bruestel/labelbee/case/lid-face.png

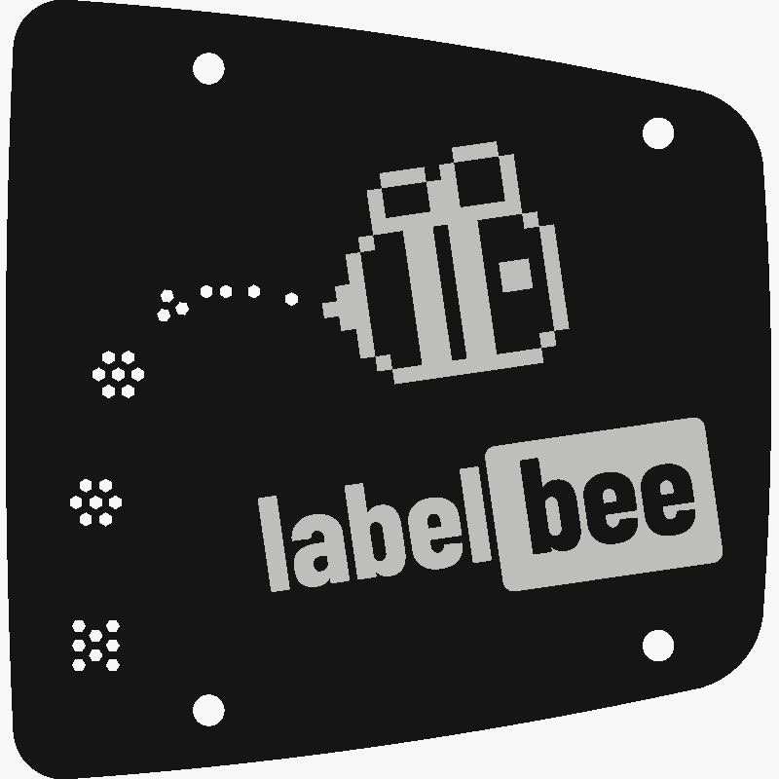
case/lid-face.png
