bruestel/labelbee/case/preview.png

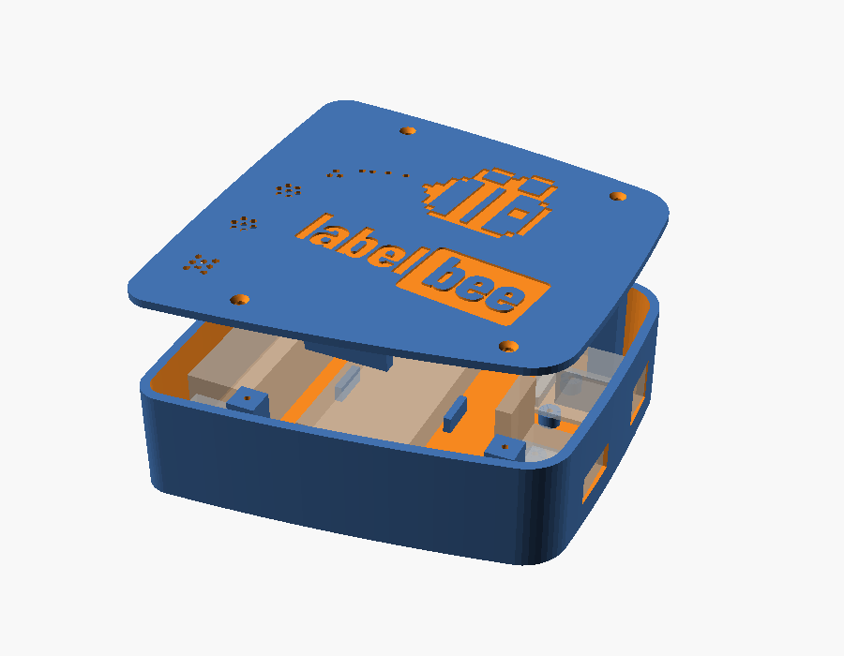
case/preview.png
