bruestel/labelbee/case/base.stl

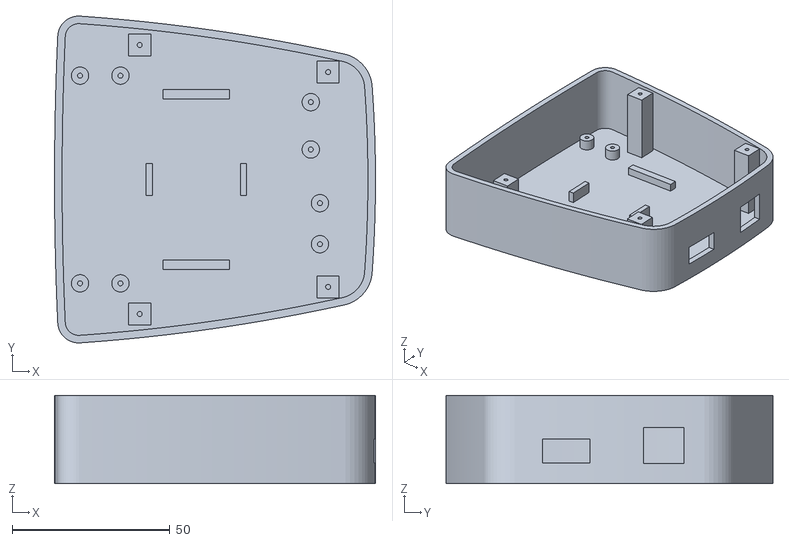
[picture p7: CAD file, 2026-10-19]
case/base.stl
101.7 x 103.6 x 28.0
