bruestel/labelbee/case/lid.stl

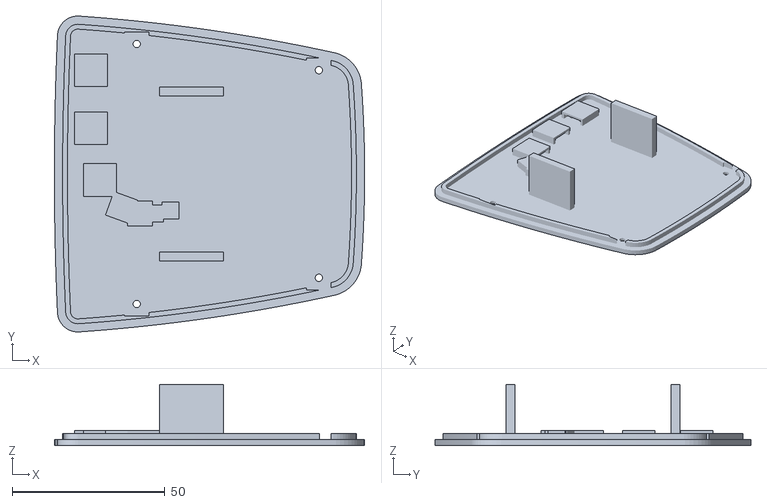
[picture p8: CAD file, 2026-10-19]
case/lid.stl
101.7 x 103.6 x 20.1
