bruestel/labelbee/case/lid-inlay.stl

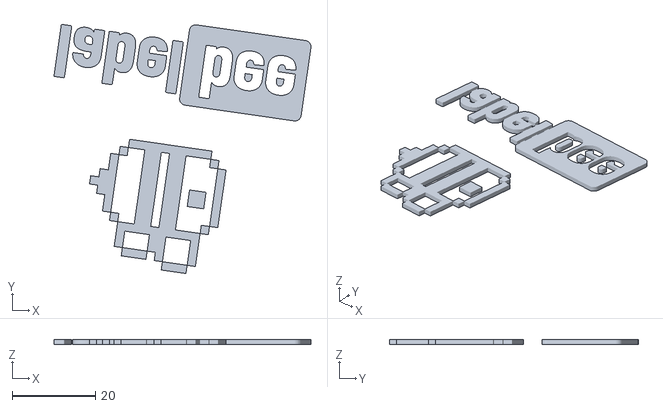
[picture p9: CAD file, 2026-10-19]
case/lid-inlay.stl
61.8 x 59.9 x 1.20
