bruestel/labelbee/src/web.h

/*
   The test page on port 80: printer power, what is on the USB port, the printer's status, a test
   label and the log (the same as the serial console), for when only the power supply is connected.
*/

#pragma once

namespace web {

void start();

}  // namespace web
