bruestel/labelbee/(commit log)

2026-10-19 labelbee: a network label printer with an ESP32-S3 and a DYMO LabelManager PnP
    [base.stl, labelbee-case.scad, lid-inlay.stl, lid.stl, partitions.csv]
2026-10-20 Narrow tapes centred, designer canvas keeps its height
    - 6 mm tape: the print head has 64 dots and a narrow tape is not centred on it, so every
    column goes out as all 64 dots (ESC D 8, ESC B 0) with the image shifted to where the tape
    lies (6 mm: from head dot 11, found with test prints).
    - Test print: upright "^TOP" and the offset at the image's top edge, `offset=N` to try
    another start dot, `ruler=1` for a ruler over the whole head.
    - Designer: fixed room above and below the tape, so selection frames and handles of tall
    elements stay visible and the canvas height never jumps; while dragging the tape stays put
    and adapts its length on release.
    [label.cpp, label.h, web.cpp]
